IsmelArab/LumiGuard-Intelligent-Dual-UV-White-Control-System/Imagenes/LumiGuard Front.png

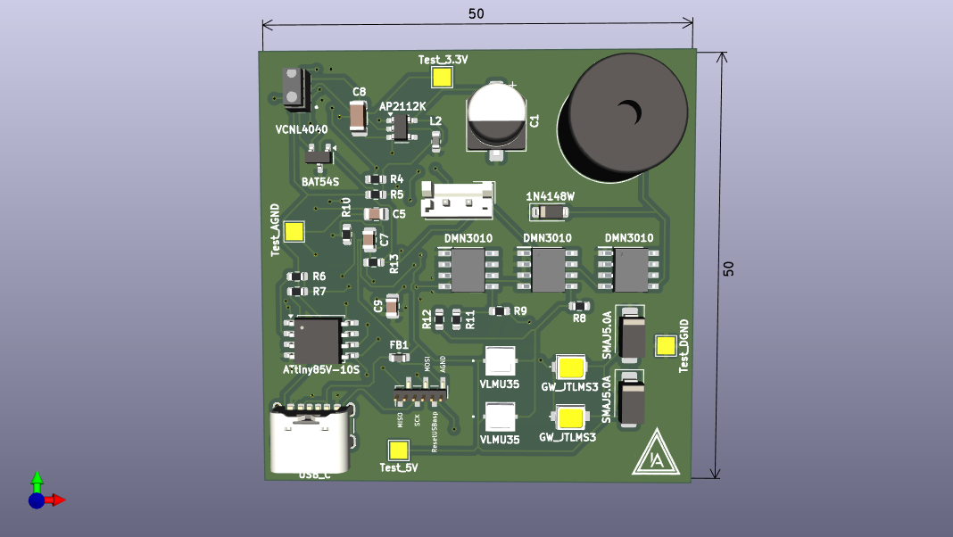
Imagenes/LumiGuard Front.png
