IsmelArab/LumiGuard-Intelligent-Dual-UV-White-Control-System/Imagenes/LumiGuard Back.png

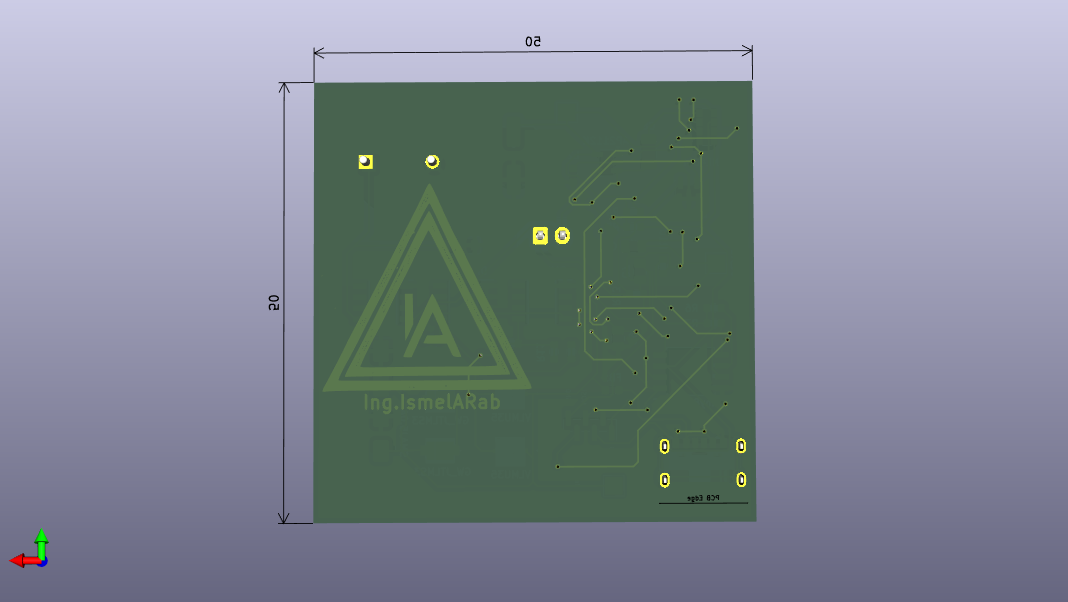
Imagenes/LumiGuard Back.png
