IsmelArab/LumiGuard-Intelligent-Dual-UV-White-Control-System/Imagenes/LumiGuard 1.png

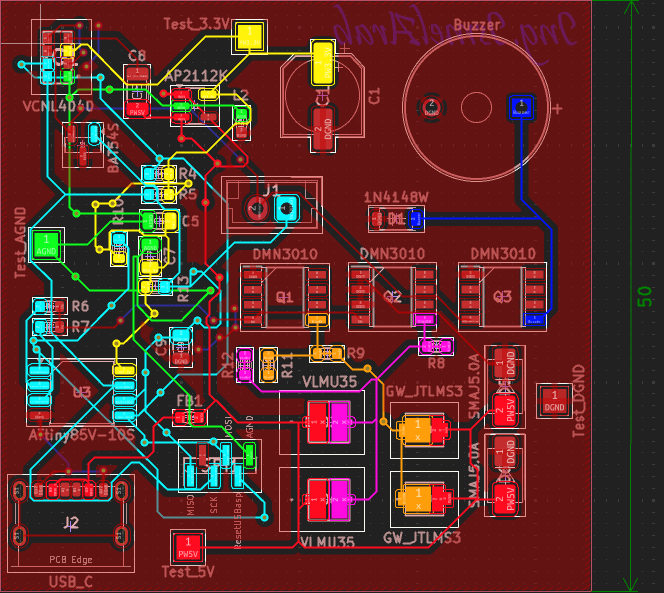
Imagenes/LumiGuard 1.png
