IsmelArab/LumiGuard-Intelligent-Dual-UV-White-Control-System/Imagenes/LumiGuard 2.png

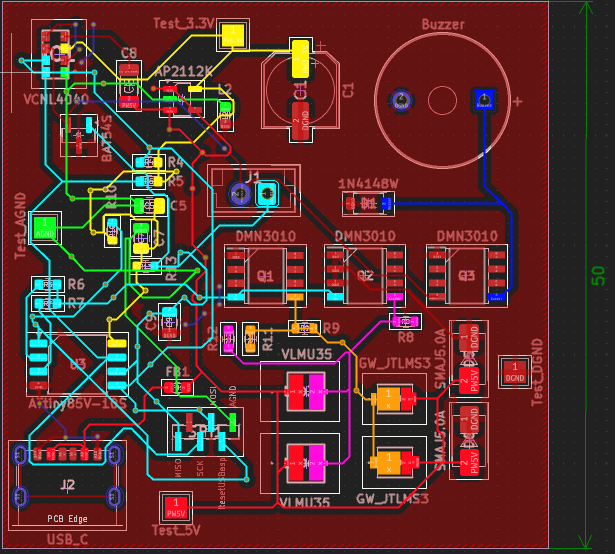
Imagenes/LumiGuard 2.png
