IsmelArab/LumiGuard-Intelligent-Dual-UV-White-Control-System/Imagenes/LumiGuard 3.png

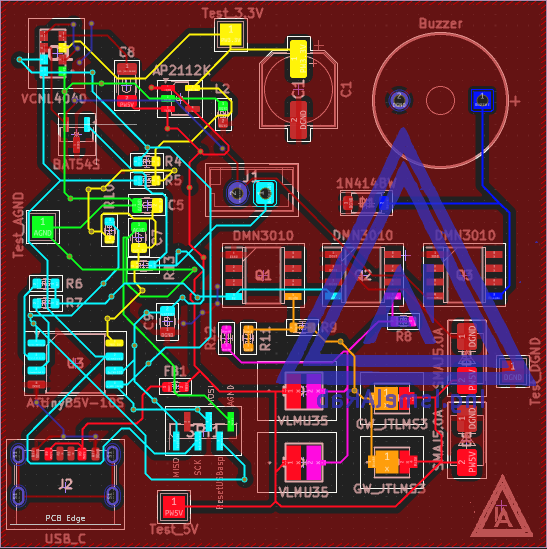
Imagenes/LumiGuard 3.png
