IsmelArab/LumiGuard-Intelligent-Dual-UV-White-Control-System/Proyecto LumiGuard KiCad/LumiGuard.kicad_pcb

## KiCad design Proyecto LumiGuard KiCad/LumiGuard.kicad_pcb (2025-03-29)

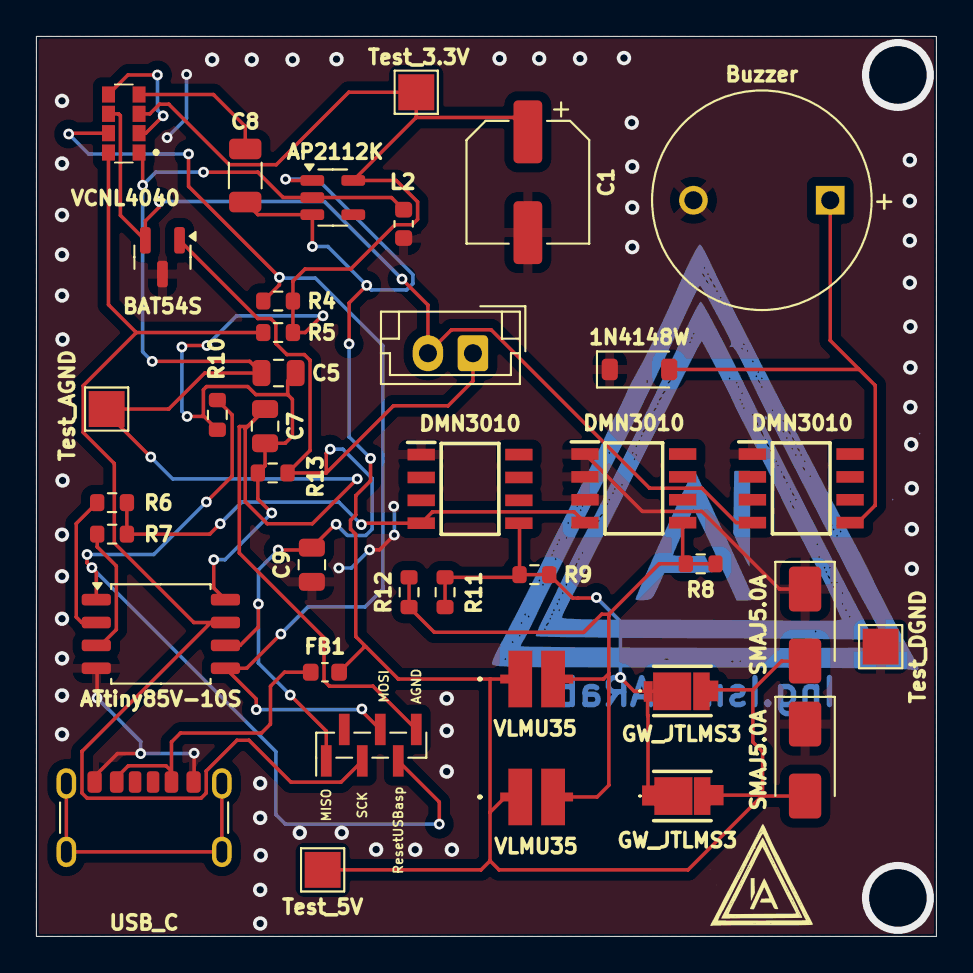
[picture p7: board LumiGuard.kicad_pcb from above]

Board: 2 copper layers, 50.0 x 50.0 mm, 39 parts (0 on the bottom side), 18 nets.

Parts:
BZ1: Buzzer; MagneticBuzzer_ProSignal_ABI-009-RC
C1: 100uF; CP_Elec_6.3x5.3
C5: 1uF; C_0805_2012Metric
C7, C9: 0.1uF; C_0805_2012Metric
C8: 2.2uF; C_1206_3216Metric
D1: 1N4148W; D_SOD-123
D2: BAT54S; SOT-23
D5, D6: SMAJ5.0A; D_SMA
FB1: 2A; L_0603_1608Metric
IC1: VCNL4040; VCNL4040M3OEH3
J1: Conn_01x02_Pin; JST_EH_B2B-EH-A_1x02_P2.50mm_Vertical
J2: USB_C; USB_C_Receptacle_GCT_USB4125-xx-x-0190_6P_TopMnt_Horizontal
L2: 100uH; L_0603_1608Metric
LED2, LED4: GW_JTLMS3; GWJTLMS3CMG6G9XX5101
LED3, LED6: VLMU35; VLMU35CL20275120
Q1, Q2, Q3: DMN3010; SOIC127P600X175-8N
R4, R5: 2.2k; R_0603_1608Metric
R6, R7, R8, R12: 100; R_0603_1608Metric
R9, R11: 150; R_0603_1608Metric
R10, R13: 10k; R_0603_1608Metric
SPI1: TSW-106-08-F-S; PinHeader_1x06_P1.00mm_Vertical_SMD_Pin1Left
TP1: Test_5V; TestPoint_Pad_2.0x2.0mm
TP2: Test_3.3V; TestPoint_Pad_2.0x2.0mm
TP3: Test_DGND; TestPoint_Pad_2.0x2.0mm
TP4: Test_AGND; TestPoint_Pad_2.0x2.0mm
U1: AP2112K; SOT-23-5
U3: ATtiny85V-10S; SOIC-8_5.3x5.3mm_P1.27mm

Connections:
/Uc: Q1.4 (G), Q2.4 (G), R6.1, R7.1
AGND: C5.1, C7.1, IC1.1 (GND), L2.1, SPI1.6, TP4.1, U1.2 (GND)
Buzzer: BZ1.1 (+), D1.2 (A), Q3.5 (D_1)
DGND: BZ1.2 (-), C1.2, C9.1, D1.1 (K), D2.3 (COM), D5.1 (A1), D6.1 (A1), J2.A12 (GND), J2.B12 (GND), L2.2, Q1.1 (S_1), Q2.1 (S_1), Q2.2 (S_2), Q2.3 (S_3), Q3.1 (S_1), TP3.1, U3.4 (GND)
DLedB: LED2.1 (K_1), LED2.3 (K_2), LED4.1 (K_1), LED4.3 (K_2), Q1.5 (D_1), R9.1, R9.2, R11.1, R11.2
DLedUV: LED3.2 (K_1), LED3.4 (K_2), LED6.2 (K_1), LED6.4 (K_2), Q2.5 (D_1), R8.1, R8.2, R12.1, R12.2
INT/GMofetBuzzer: D2.2 (K), IC1.6 (INT), J1.2, Q3.4 (G)
unnamed: C8.1, IC1.4 (ANODE)
unnamed: IC1.2 (CATHODE_(SENSOR)), IC1.5 (CATHODE_(LED))
PW3.3V: C1.1, C5.2, C7.2, IC1.3 (VDD), R4.2, R5.2, R10.2, R13.2, TP2.1, U1.5 (VOUT), U3.8 (VCC)
PW5V: C8.2, D5.2 (A2), D6.2 (A2), FB1.2, LED2.2 (A_1), LED2.4 (A_2), LED3.1 (A_1), LED3.3 (A_2), LED4.2 (A_1), LED4.4 (A_2), LED6.1 (A_1), LED6.3 (A_2), TP1.1, U1.1 (VIN), U1.3 (EN)
PW5V_1: FB1.1, J2.A9 (VBUS), J2.B9 (VBUS)
Uc(MISO): C9.2, D2.1 (A), J1.1, R13.1, SPI1.1, U3.6 (PB1)
Uc(MOSI (SDAT)): IC1.7 (SDAT), R4.1, SPI1.4, U3.5 (AREF/PB0)
Uc(ResetUSBasp): R10.1, SPI1.5, U3.1 (~RESET/PB5)
Uc(SCK(SCKL)): IC1.8 (SCLK), R5.1, SPI1.3, U3.7 (PB2)
Uc(control led UV): R7.2, U3.3 (XTAL2/PB4)
Uc(control led blancos): R6.2, U3.2 (XTAL1/PB3)
